bigowash/Face-Tracking-Robotic-Arm/code/CameraCode/CameraCode.ino

// For camera
//#include "camera_index.h"
#include "esp_camera.h"
#include "fb_gfx.h"
#include "fd_forward.h"
#include <WiFi.h>

// for averaging the distance result
// Define the number of samples to keep track of. The higher the number, the
// more the readings will be smoothed, but the slower the output will respond to
// the input.
const int numReadings = 4;
int readings[numReadings]; // the readings from the analog input
int readIndex = 0;         // the index of the current reading
int total = 0;             // the running total
int pixel_face_size = 30;  // the average
int face_distance;

#define CAMERA_MODEL_AI_THINKER
#include "camera_pins.h"

const char *ssid = "Android";
const char *password = "mejdimej";

static inline mtmn_config_t app_mtmn_config()
{
    mtmn_config_t mtmn_config = {0};
    mtmn_config.type = FAST;
    mtmn_config.min_face = 60; // 80 default
    mtmn_config.pyramid = 0.707;
    mtmn_config.pyramid_times = 4;
    mtmn_config.p_threshold.score = 0.6;
    mtmn_config.p_threshold.nms = 0.7;
    mtmn_config.p_threshold.candidate_number = 20;
    mtmn_config.r_threshold.score = 0.7;
    mtmn_config.r_threshold.nms = 0.7;
    mtmn_config.r_threshold.candidate_number = 10;
    mtmn_config.o_threshold.score = 0.7;
    mtmn_config.o_threshold.nms = 0.7;
    mtmn_config.o_threshold.candidate_number = 1;
    return mtmn_config;
}
mtmn_config_t mtmn_config = app_mtmn_config();

void startCameraServer();

void setup()
{

    // initialize the serial port:
    Serial.begin(115200);
    Serial2.begin(9600, SERIAL_8N1, 2, 14);
    Serial.setDebugOutput(true);
    Serial.println();

    camera_config_t config;
    config.ledc_channel = LEDC_CHANNEL_0;
    config.ledc_timer = LEDC_TIMER_0;
    config.pin_d0 = Y2_GPIO_NUM;
    config.pin_d1 = Y3_GPIO_NUM;
    config.pin_d2 = Y4_GPIO_NUM;
    config.pin_d3 = Y5_GPIO_NUM;
    config.pin_d4 = Y6_GPIO_NUM;
    config.pin_d5 = Y7_GPIO_NUM;
    config.pin_d6 = Y8_GPIO_NUM;
    config.pin_d7 = Y9_GPIO_NUM;
    config.pin_xclk = XCLK_GPIO_NUM;
    config.pin_pclk = PCLK_GPIO_NUM;
    config.pin_vsync = VSYNC_GPIO_NUM;
    config.pin_href = HREF_GPIO_NUM;
    config.pin_sscb_sda = SIOD_GPIO_NUM;
    config.pin_sscb_scl = SIOC_GPIO_NUM;
    config.pin_pwdn = PWDN_GPIO_NUM;
    config.pin_reset = RESET_GPIO_NUM;
    config.xclk_freq_hz = 20000000;
    config.pixel_format = PIXFORMAT_JPEG;
    //init with high specs to pre-allocate larger buffers
    if (psramFound())
    {
        config.frame_size = FRAMESIZE_UXGA;
        config.jpeg_quality = 10;
        config.fb_count = 2;
    }
    else
    {
        config.frame_size = FRAMESIZE_SVGA;
        config.jpeg_quality = 12;
        config.fb_count = 1;
    }

#if defined(CAMERA_MODEL_ESP_EYE)
    pinMode(13, INPUT_PULLUP);
    pinMode(14, INPUT_PULLUP);
#endif

    // camera init
    esp_err_t err = esp_camera_init(&config);
    if (err != ESP_OK)
    {
        Serial.printf("Camera init failed with error 0x%x", err);
        return;
    }

    sensor_t *s = esp_camera_sensor_get();
    s->set_framesize(s, FRAMESIZE_QVGA);

    WiFi.begin(ssid, password);

    while (WiFi.status() != WL_CONNECTED)
    {
        delay(500);
        Serial.print(".");
    }
    Serial.println("");
    Serial.println("WiFi connected");

    startCameraServer();

    Serial.print("Camera Ready! Use 'http://");
    Serial.print(WiFi.localIP());
    Serial.println("' to connect");
}

static void draw_face_boxes(dl_matrix3du_t *image_matrix, box_array_t *boxes)
{
    int x, y, w, h, i, half_width, half_height;
    fb_data_t fb;
    fb.width = image_matrix->w;
    fb.height = image_matrix->h;
    fb.data = image_matrix->item;
    fb.bytes_per_pixel = 3;
    fb.format = FB_BGR888;
    for (i = 0; i < boxes->len; i++)
    {

        // Convoluted way of finding face centre...
        x = ((int)boxes->box[i].box_p[0]);
        w = (int)boxes->box[i].box_p[2] - x + 1;
        half_width = w / 2;
        int face_center_pan = x + half_width; // current face centre x co-ordinate

        y = (int)boxes->box[i].box_p[1];
        h = (int)boxes->box[i].box_p[3] - y + 1;
        half_height = h / 2;
        int face_center_tilt = y + half_height; // current face centre y co-ordinate

        // Serial.print("this is h: ");
        // Serial.println(h);
        // Serial.print("this is x:  ");
        // Serial.println(face_center_pan - 160);
        // Serial.print("this is y:  ");
        // Serial.println(120 - face_center_tilt);

        // Serial.print("rotation:     ");
        // Serial.println(map(face_center_pan, 0, 320, -32.5, 32.5));
        // Serial.print("height:     ");
        // Serial.println((195 * (120 - face_center_tilt)) / pixel_face_size);
        // Serial.print("smoothed face height: ");
        // Serial.println(pixel_face_size);

        // subtract the last reading:
        total = total - readings[readIndex];
        // add current face height:
        readings[readIndex] = h;
        // add the reading to the total:
        total = total + readings[readIndex];
        // advance to the next position in the array:
        readIndex = readIndex + 1;

        // if we're at the end of the array...
        if (readIndex >= numReadings)
        {
            // ...wrap around to the beginning:
            readIndex = 0;
        }

        // calculate the average:
        pixel_face_size = total / numReadings;

        int eq_top = 3.6 * 200 * 240;          //f(mm) x real height(mm) x image height(px)
        int eq_bottom = pixel_face_size * 2.7; //object height(px) x sensor height(mm)
        int face_distance = eq_top / eq_bottom;
        Serial.print("face_distance: ");
        Serial.println(face_distance);

        Serial2.print('<'); // start marker
        Serial2.print(face_center_pan - 160);
        Serial2.print(','); // comma separator
        Serial2.print(240 - face_center_tilt);
        Serial2.print(','); // comma separator
        Serial2.print(pixel_face_size);
        Serial2.println('>'); // end marker
    }
}

void loop()
{
    Serial.println("");

    camera_fb_t *fb = NULL;
    dl_matrix3du_t *image_matrix = NULL;
    fb = esp_camera_fb_get();

    image_matrix = dl_matrix3du_alloc(1, fb->width, fb->height, 3);
    fmt2rgb888(fb->buf, fb->len, fb->format, image_matrix->item);
    box_array_t *net_boxes = NULL;
    net_boxes = face_detect(image_matrix, &mtmn_config);

    if (net_boxes)
    {
        draw_face_boxes(image_matrix, net_boxes);
        free(net_boxes->score);
        free(net_boxes->box);
        free(net_boxes->landmark);
        free(net_boxes);
    }
    esp_camera_fb_return(fb);
    fb = NULL;
    dl_matrix3du_free(image_matrix);
}
